system76/thelio-io-hardware/(threads)

Thread 1 (2018-10-01):

No Qi Charger

ahoneybun, 2018-10-01:
I thought we were dropping the Qi Charging part of the case?

WatchMkr, 2018-10-02:
That's correct. Qi charging will not be part of Thelio.

Closed 2018-10-02.

Thread 4 (2018-12-11):

C0 tolerance

jackpot51, 2018-12-11:
C0 had to be replaced on a few boards due to tolerances being too large. Find a replacement with lower tolerance

Closed 2019-05-27.

Thread 12 (2023-03-22):

thelio-io-sata 2.0 missing solder paste mask openings SATA drive connector mounting pads

dlharmon, 2023-03-22:

dlharmon, 2023-04-19:
Addressed in #11

Closed 2023-04-19.
