system76/thelio-io-hardware/(commit log)

2018-09-12 Add kicad files
    [button.sch, ec.sch, fan.sch, qi.sch, sas.sch, sata.sch, thelio-io.kicad_pcb, thelio-io.sch]
2018-09-12 Update gitignore and clean up schematics
    [button.sch, ec.sch, fan.sch, qi.sch, sata.sch, thelio-io.sch]
2018-09-12 Move SAS schematic
    [thelio-io-sas.sch]
2018-09-12 Add script for generating drill and gerber files
2018-09-13 Implement thelio-io-sas
    [button.sch, sas0.sch, sas1.sch, thelio-io-sas.kicad_pcb, thelio-io-sas.sch, thelio-io.kicad_pcb]
2018-09-13 Make board have 4 U.2 connectors
    [sas0.sch, sas2.sch, sas3.sch, thelio-io-sas.kicad_pcb, thelio-io-sas.sch]
2018-09-13 Extend board to add room for two more screws
    [thelio-io-sas.kicad_pcb]
2018-09-13 Add power0 to thelio-io-sas
    [button.sch, ec.sch, fan.sch, qi.sch, sas0.sch, sas1.sch, sas2.sch, sas3.sch]
2018-09-24 Extend board 3mm
    [thelio-io-sas.kicad_pcb]
2018-10-01 Fix sata and data references
    [thelio-io.kicad_pcb]
2018-10-03 Convert screwholes to tabs
    [thelio-io.kicad_pcb]
2018-10-03 Make tabs larger
    [thelio-io.kicad_pcb]
2018-10-04 Update thelio-io-sas to match new dimensions
    [thelio-io-sas.kicad_pcb]
2018-10-04 Reload PCB's with version 5
    [thelio-io-sas.kicad_pcb, thelio-io.kicad_pcb]
2018-10-04 Modify edge cuts again
    [thelio-io-sas.kicad_pcb, thelio-io.kicad_pcb]
2018-10-08 Add BOM
    [thelio-io-bom.csv, thelio-io-sas-bom.csv]
2018-10-08 Mark everything smd so it is included in footprint file
    [thelio-io.kicad_pcb]
2018-10-08 Add power connector to SAS BOM
    [thelio-io-sas-bom.csv]
2018-10-22 Add OSHW logos
    [thelio-io-sas.kicad_pcb, thelio-io.kicad_pcb]
2018-10-22 Fix BOM for thelio-io
    [thelio-io-bom.csv]
2018-10-27 Fix missing port 3 and 4
    [thelio-io-sas-bom.csv]
2018-11-01 Update schematics
    [sas0.sch, sas1.sch, sas2.sch, sas3.sch]
2018-11-01 Reroute thelio-io-sas
    [thelio-io-sas.kicad_pcb]
2018-11-01 Commit position files as well
    [thelio-io-all-pos.csv, thelio-io-sas-all-pos.csv]
2018-11-05 Use normal vias for thelio-io-sas
    [thelio-io-sas.kicad_pcb]
2018-11-05 Do not allow microvias
    [thelio-io-sas.kicad_pcb]
2018-11-06 Increase size of power tracks
    [thelio-io-sas.kicad_pcb, thelio-io.kicad_pcb]
2018-11-06 Increase size of power tracks to first connector
    [thelio-io-sas.kicad_pcb, thelio-io.kicad_pcb]
2018-11-09 Cleanup bom
    [thelio-io-bom.csv, thelio-io-sas-bom.csv]
2018-11-15 Another WIP SAS reroute
    [sas0.sch, sas1.sch, sas2.sch, sas3.sch, thelio-io-sas.kicad_pcb]
2018-11-15 Set design rules and add vias
    [thelio-io-sas.kicad_pcb]
2018-11-15 Reroute traces
    [thelio-io-sas.kicad_pcb]
2018-11-15 Update BOM and footprints
    [thelio-io-sas-bom.csv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]
2018-11-27 Length matching of PCIE traces
    [thelio-io-sas.kicad_pcb]
2018-12-17 Reroute SAS board, increasing layer count to six. Add stitching vias
    [thelio-io-sas.kicad_pcb]
2019-01-07 Increase size of chip resistors and capacitors to 0402 Connect SATA data ground to ground plane Increase size of SATA data lines
    [button.sch, ec.sch, fan.sch, qi.sch, sata.sch, thelio-io-bom.csv, thelio-io.kicad_pcb, thelio-io.sch]
2019-01-07 Update footprint position file
    [thelio-io.kicad_pcb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]
2019-01-08 Remove two screw holes from SAS connector
2019-01-08 Replace 0402 parts with 0603
    [thelio-io-bom.csv, thelio-io.kicad_pcb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]
2019-01-10 Reroute of thelio-io-sas
    [thelio-io-sas.kicad_pcb]
2019-01-11 Print out microstrip coupler requirements for coupled microstrip
2019-01-14 Add ground plane cuts
    [thelio-io-sas.kicad_pcb]
2019-01-30 Add logo to sas board
    [thelio-io-sas.kicad_pcb]
2022-12-06 WIP: v2
    [button.sch, ec.sch, fan.sch, sas0.sch, sas1.sch, sas2.sch, sas3.sch, sata.sch]
2022-12-12 Layout improvements
    [thelio-io.kicad_pcb, thelio-io.kicad_sch]
2022-12-12 More layout improvements
    [thelio-io.kicad_pcb]
2022-12-12 Routing improvements
    [thelio-io.kicad_pcb]
2022-12-12 Add keepout
    [thelio-io.kicad_pcb]
2022-12-12 Switch CPU and INTAKE fans
    [thelio-io.kicad_pcb]
2022-12-12 Add logo and fix keepouts
    [thelio-io.kicad_pcb, thelio-io.kicad_sch]
2022-12-12 Adjust spacing between power button pins
    [thelio-io.kicad_pcb]
2022-12-12 Re-add logo
    [thelio-io.kicad_pcb]
2022-12-13 Update SATA design
    [thelio-io-sata.kicad_pcb]
2022-12-15 SATA 7 pin pinout the footprint was mirrored with pin 1 being where 7 should have been corrected footprint, mirrored symbol in schematic no physical changes, just pin numbers and net names give SATA 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
    [thelio-io-sata.kicad_sch]
2022-12-15 signal integrity on SATA lines Add stackup with controlled impedance, 4 layers ground planes on inners ground vias plane cutouts
    [thelio-io-sata.kicad_pcb]
2022-12-15 correct core thickness turn off high contrast
    [thelio-io-sata.kicad_pcb]
2022-12-15 Make 4-layer and improve fills
    [thelio-io.kicad_pcb, thelio-io.kicad_sch]
2022-12-15 Fix top edge of thelio-io-sata
    [thelio-io-sata.kicad_pcb]
2022-12-16 decoupling, etc add 3x 1 uF decoupling caps change UCAP from 22 pF to 1 uF as required by AVR datasheet R3 0201 to 0603 package R2 100 to 22 ohm add part number for crystal move VCC planelet to In1.C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
    [thelio-io.kicad_pcb, thelio-io.kicad_sch]
2022-12-21 Fix thelio-io-sata edge cut
    [thelio-io-sata.kicad_pcb]
2023-01-05 part numbers, export settings
    [thelio-io-sata.kicad_pcb, thelio-io-sata.kicad_sch, thelio-io.kicad_pcb, thelio-io.kicad_sch]
2023-01-05 refill polygons, sync with schematic
    [thelio-io-sata.kicad_pcb]
2023-01-05 change USB connector to Molex SL style
    [thelio-io.kicad_pcb, thelio-io.kicad_sch]
2023-01-12 enable export of User.Comments in gerbers
    [thelio-io-sata.kicad_pcb, thelio-io.kicad_pcb]
2023-02-23 v2 with RP2040
    [thelio-io.kicad_pcb, thelio-io.kicad_sch]
2023-02-23 resolve ERC warnings move U2 silkscreen
    [thelio-io.kicad_pcb, thelio-io.kicad_sch]
2023-02-23 replace .wrl models with .step
    [thelio-io.kicad_pcb]
2023-02-23 bump revision to 2.1 2.0 was submitted for quote but will never be built
    [thelio-io.kicad_pcb, thelio-io.kicad_sch]
2023-03-20 save in Kicad 7
    [thelio-io-sata.kicad_pcb, thelio-io-sata.kicad_sch]
2023-03-20 thelio-io-sata 2.0 add SMT standoffs, move connector locations
    [thelio-io-sata.kicad_pcb, thelio-io-sata.kicad_sch]
2023-03-20 move SATA board into separate folder
    [thelio-io-sata.kicad_pcb, thelio-io-sata.kicad_sch]
2023-04-10 rename io-sata folder, add to gitignore
    [thelio-io-sata.kicad_pcb, thelio-io-sata.kicad_sch]
2023-04-10 solder paste on mounting pads, add pin to electrically connect them to the ground plane to add mechanical strength
2023-04-10 correct type to through hole
2023-04-10 silkscreen to show correct orientation
2023-04-13 thelio-io-sata 2.2 shrink board outline reduce number of mounting standoffs use PEM part number
    [thelio-io-sata.kicad_pcb, thelio-io-sata.kicad_sch]
2023-04-19 move thelio-io PCB to directory
    [thelio-io.kicad_pcb, thelio-io.kicad_sch]
2023-04-19 standoffs, button, etc add M3 SMT standoffs move power button to back remove reset button replace boot button with test points add power LED
    [thelio-io.kicad_pcb, thelio-io.kicad_sch]
2023-05-12 2.2 add relay to disable power switch
    [thelio-io.kicad_pcb, thelio-io.kicad_sch]
2023-06-02 Add nebula_io_2.2
    [nebula-io.kicad_pcb, nebula-io.kicad_sch]
2023-06-08 correct relay part number to G6K-2F-Y-TR DC5, was mising the DC5 part.
    [thelio-io.kicad_pcb, thelio-io.kicad_sch]
2023-06-18 2.3 add resistor divider to ADCs, caps install pull ups resistor across power LED input from motherboard
    [thelio-io.kicad_pcb, thelio-io.kicad_sch]
2023-08-11 add silkscreen line to indicate orientation of power input connector
    [thelio-io.kicad_pcb]
